Wenjin-GM/ELF_Baobaodui/vision/inventory/auto_verify_annotated.jpg

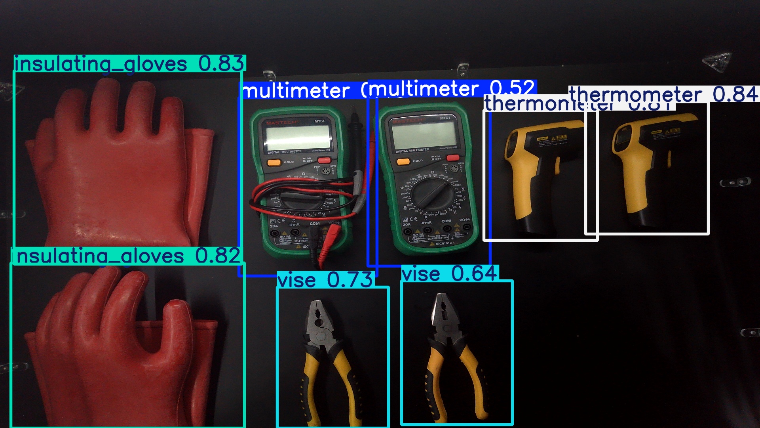
vision/inventory/auto_verify_annotated.jpg
