Wenjin-GM/ELF_Baobaodui/vision/inventory/verify_annotated.jpg

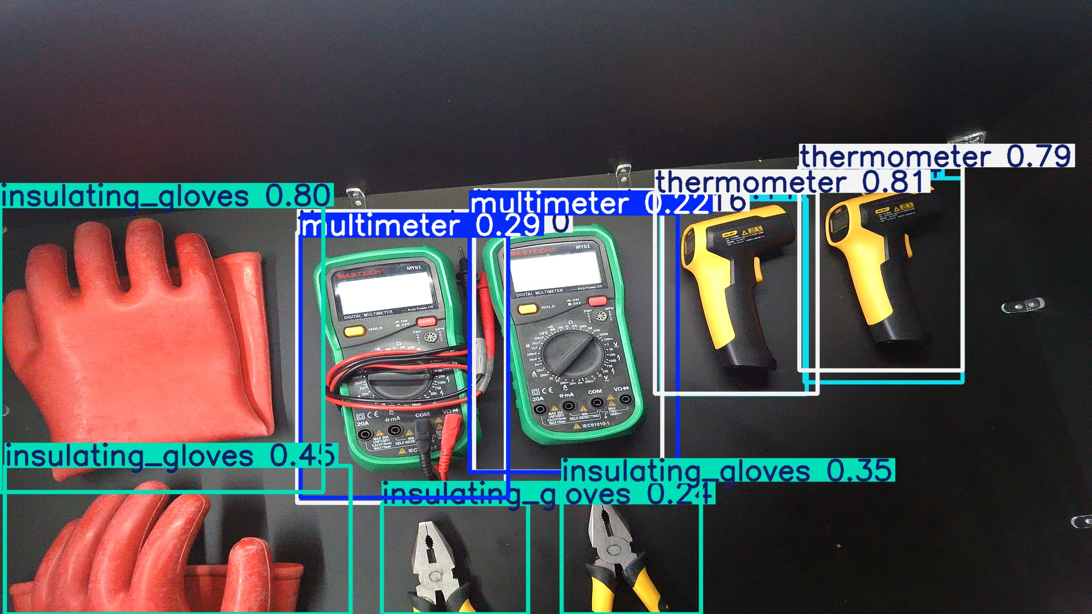
vision/inventory/verify_annotated.jpg
