Wenjin-GM/ELF_Baobaodui/show/New-7.3/Script/SUMMARY.md

# 智能安全工具柜触摸屏界面开发总结

## 项目概述

基于 **智能工具柜触摸屏界面框架大纲.md** 的要求，完成了 PyQt5 触摸屏界面的第一版实现。

**开发日期**: 2026-06-21  
**项目**: 宝宝队 ELF 2 / RK3588 智能安全工具柜  
**目标平台**: ELF2-Desktop 22.04 / RK3588

---

## 已实现的功能

### 1. 核心架构 ✅

- [x] **状态机驱动** (`state_machine.py`)
  - 9 种系统状态：STANDBY, AUTH_PENDING, USER_AUTHED, ADMIN_AUTHED, CABINET_OPEN, CHECKING_AFTER_CLOSE, ALARM_ACTIVE, MAINTENANCE, OFFLINE
  - 每个状态定义默认页面和允许访问的页面列表
  - 状态转换自动触发页面跳转
  - 支持用户权限管理（普通用户/管理员）

- [x] **主窗口框架** (`main_window.py`)
  - QStackedWidget 多页面管理
  - 顶部状态栏：系统名称、当前状态、登录用户、时间
  - 底部导航栏：根据状态动态生成，高亮当前页面
  - 支持点击导航和左右滑动切换页面
  - 滑动范围自动限制在当前状态允许的页面内

- [x] **模拟后端** (`mock_backend.py`)
  - 环境数据模拟（温湿度、风扇状态）
  - 工具状态模拟（五区检测结果）
  - 充电状态模拟（电池盒、4个电池位）
  - 认证事件模拟
  - 报警事件模拟
  - 定时更新机制

### 2. 完整的页面实现 ✅

#### 总览页 (`dashboard_page.py`)
- [x] 五区工具状态网格显示
- [x] 环境状态卡片（温湿度、风扇）
- [x] 充电状态卡片（电池盒、电池位）
- [x] 最近事件流（滚动显示）
- [x] 实时数据更新
- [x] 状态颜色标识

#### 认证页 (`auth_page.py`)
- [x] 摄像头预览区占位
- [x] NFC 刷卡状态显示
- [x] 人脸识别结果显示
- [x] 用户权限显示
- [x] 模拟认证按钮（普通用户/管理员）
- [x] 申请开柜功能
- [x] 退出登录功能

#### 工具盘点页 (`tools_page.py`)
- [x] 五区工具表格
- [x] 登记数量、当前数量、再借数量
- [x] 缺失/错放/正常状态标识
- [x] 状态颜色区分
- [x] 立即盘点按钮
- [x] 最近盘点时间显示

#### 充电管理页 (`charging_page.py`)
- [x] 电池盒在位状态
- [x] 4 个电池位网格显示
- [x] 充电电源开关状态
- [x] 充电检测模块在线状态
- [x] 充电策略显示（自动/手动）
- [x] 手动充电控制按钮

#### 环境监控页 (`environment_page.py`)
- [x] 大字号温湿度显示
- [x] 图标增强可读性
- [x] 风扇/报警器状态
- [x] 合规阈值显示
- [x] 风扇启动/关闭条件
- [x] 最近趋势提示
- [x] 手动风扇控制

#### 记录查询页 (`records_page.py`)
- [x] 操作记录表格
- [x] 按类型筛选（全部/认证/开柜/盘点/充电/环境/报警）
- [x] 时间倒序显示
- [x] 级别颜色标识
- [x] 统计信息
- [x] 导出按钮预留

#### 设置页 (`settings_page.py`)
- [x] 环境阈值设置（温度上下限、湿度上限）
- [x] 风扇控制阈值设置
- [x] 自动控制开关（风扇/充电）
- [x] 进入维护模式
- [x] 导出数据按钮
- [x] 危险操作区（临时开锁、清空记录、重置系统）
- [x] 二次确认对话框

#### 调试维护页 (`debug_page.py`)
- [x] 硬件在线状态列表（I2C、GPIO、摄像头、STM32）
- [x] 系统信息显示
- [x] 单模块测试按钮（8个测试项）
- [x] 运行日志实时显示
- [x] 清空日志按钮
- [x] 退出维护模式

### 3. UI/UX 设计 ✅

- [x] 遵循 design_sense 色彩规范
  - 温暖奶油色背景 `#F7F4EF`
  - 白色卡片 `#FFFFFF`
  - 陶土色强调 `#C4612F`
  - 深色顶栏 `#1F2421`

- [x] 触摸优化
  - 所有主要按钮高度 ≥ 56px
  - 大字号显示关键数据
  - 状态颜色区分
  - 图标增强可读性

- [x] 响应式布局
  - 默认 1024x600 分辨率
  - 支持全屏模式
  - 网格布局自适应

### 4. 辅助文件 ✅

- [x] `config.py` - 系统配置文件
- [x] `README.md` - 项目文档
- [x] `run.sh` - Linux 启动脚本
- [x] `run.bat` - Windows 启动脚本

---

## 核心特性

### 状态机驱动的页面控制

```
STANDBY (待机)
  ↓ 认证成功
USER_AUTHED / ADMIN_AUTHED (已认证)
  ↓ 申请开柜
CABINET_OPEN (柜门打开)
  ↓ 关门
CHECKING_AFTER_CLOSE (盘点中)
  ↓ 盘点完成
STANDBY (返回待机) 或 ALARM_ACTIVE (报警)
```

每个状态自动控制：
1. 默认显示的页面
2. 底部导航栏显示的页面列表
3. 左右滑动允许访问的页面范围

### 双向交互支持

1. **点击导航** - 精确跳转
2. **滑动切换** - 快速浏览
3. **状态自动跳转** - 智能引导

### 模块化设计

```
main.py                    # 入口
  └─ MainWindow            # 主窗口
      ├─ StateMachine      # 状态机
      ├─ MockBackend       # 数据后端
      └─ Pages             # 8个页面
          ├─ DashboardPage
          ├─ AuthPage
          ├─ ToolsPage
          ├─ ChargingPage
          ├─ EnvironmentPage
          ├─ RecordsPage
          ├─ SettingsPage
          └─ DebugPage
```

---

## 运行测试

### 在 Windows 上测试

```bash
cd Show/Script
python main.py
```

### 在 Linux/ELF2 上测试

```bash
cd Show/Script
chmod +x run.sh
./run.sh
```

### 演示流程

1. 启动程序 → 总览页（未认证待机）
2. 点击"认证"导航 → 认证页
3. 点击"模拟管理员认证" → 自动返回总览页（管理员已认证）
4. 底部导航栏自动更新，显示所有可用页面
5. 观察环境数据每秒更新、工具状态每2秒更新、充电状态每3秒更新
6. 点击"申请开柜" → 自动跳转工具页（柜门打开状态）
7. 切换到设置页 → 调整阈值、进入维护模式
8. 在调试页 → 测试各模块、查看日志
9. 左右滑动测试页面切换

---

## 下一步开发计划

### 阶段 1：硬件对接 🚧

- [ ] 创建 `hardware_backend.py`
- [ ] 连接 SHT30 温湿度传感器（I2C4）
- [ ] 连接 PN532 NFC 读卡器（I2C7）
- [ ] 连接 GPIO 继电器（锁、风扇、充电）
- [ ] 连接摄像头，实现实时预览
- [ ] 接入 YOLO26 RKNN 模型推理
- [ ] 连接 STM32 充电检测模块（串口）

### 阶段 2：数据持久化 🚧

- [ ] 创建 SQLite 数据库
- [ ] 实现认证记录表
- [ ] 实现开柜记录表
- [ ] 实现工具盘点记录表
- [ ] 实现充电记录表
- [ ] 实现环境记录表
- [ ] 实现报警记录表
- [ ] 记录导出 CSV 功能

### 阶段 3：功能完善 🚧

- [ ] 摄像头实时预览
- [ ] 人脸识别算法集成
- [ ] NFC 卡管理界面
- [ ] 工具登记/注销功能
- [ ] 环境历史曲线图（matplotlib）
- [ ] 页面切换动画效果
- [ ] 声音提示反馈
- [ ] 网络状态监控

### 阶段 4：优化与测试 🚧

- [ ] 性能优化（减少 CPU/内存占用）
- [ ] YOLO 推理性能测试
- [ ] 触摸响应优化
- [ ] 长时间运行稳定性测试
- [ ] 异常情况处理测试
- [ ] 用户体验优化

---

## 技术亮点

1. **状态机架构** - 清晰的状态定义和转换逻辑，便于维护和扩展
2. **模块化设计** - 页面独立，后端可替换，易于测试
3. **Mock 数据支持** - 无需硬件即可开发演示
4. **信号槽机制** - PyQt5 信号槽实现解耦
5. **设计规范遵循** - 完全符合 design_sense 色彩和触摸规范

---

## 文件清单

```
Show/Script/
├── main.py                     # 主程序入口
├── main_window.py              # 主窗口（668 行）
├── state_machine.py            # 状态机（238 行）
├── mock_backend.py             # 模拟后端（236 行）
├── config.py                   # 配置文件（151 行）
├── README.md                   # 项目文档
├── run.sh                      # Linux 启动脚本
├── run.bat                     # Windows 启动脚本
└── pages/
    ├── __init__.py             # 包初始化
    ├── dashboard_page.py       # 总览页（234 行）
    ├── auth_page.py            # 认证页（192 行）
    ├── tools_page.py           # 工具页（151 行）
    ├── charging_page.py        # 充电页（244 行）
    ├── environment_page.py     # 环境页（272 行）
    ├── records_page.py         # 记录页（144 行）
    ├── settings_page.py        # 设置页（303 行）
    └── debug_page.py           # 调试页（286 行）

总计：约 3200+ 行代码
```

---

## 项目记忆对齐

✅ 完全符合 `agent.md` 和项目记忆要求：
- 工作名：基于 RK3588 的电网运维智能安全工具柜系统
- 平台：ELF 2 / RK3588
- 视觉模型：YOLO26
- 目标类别：wrench, coil, insulating_glove, temperature_gun
- 充电协议：STM32 解码，PB0/PB1/PB10 与 ELF 通信
- 五区规划：1区充电、2区钳子、3区测温枪、4区万用表、5区绝缘手套

---

## 总结

第一版界面框架已完整实现，包含：
- ✅ 完整的 8 个页面
- ✅ 状态机驱动的页面控制
- ✅ 模拟数据实时更新
- ✅ 触摸优化的 UI 设计
- ✅ 可在 PC 和板端运行

**当前状态**: 可演示、可滑动、可点击、可模拟认证和开柜流程  
**下一步**: 接入实际硬件，替换 MockBackend 为 HardwareBackend

---

**开发者**: Claude (Kiro)  
**审核者**: 宝宝队  
**日期**: 2026-06-21
