Wenjin-GM/ELF_Baobaodui/show/New-7.3/Script/resources/ui_images/charging_box.png

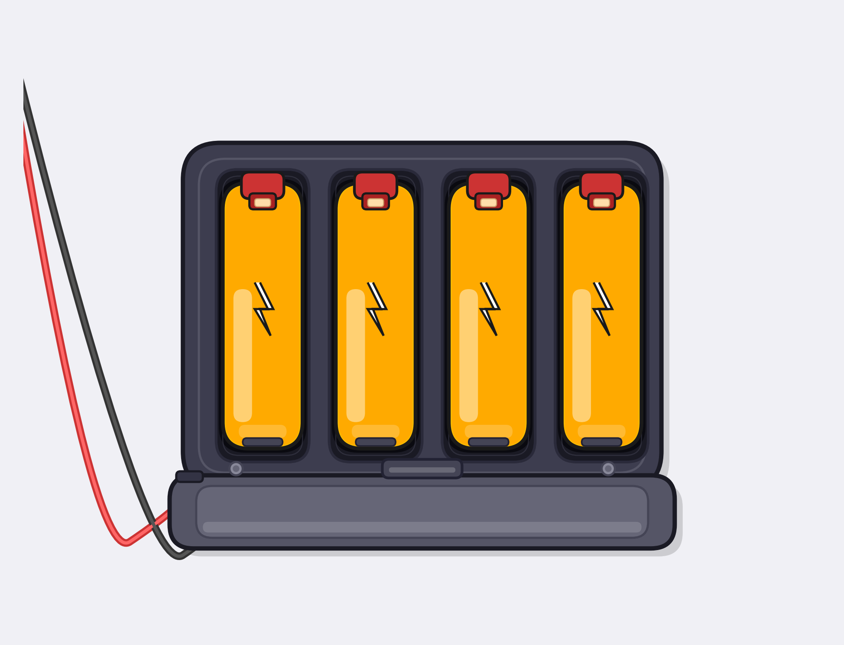
show/New-7.3/Script/resources/ui_images/charging_box.png
