Wenjin-GM/ELF_Baobaodui/show/New-7.3/Script/resources/ui_images/environment_status.png

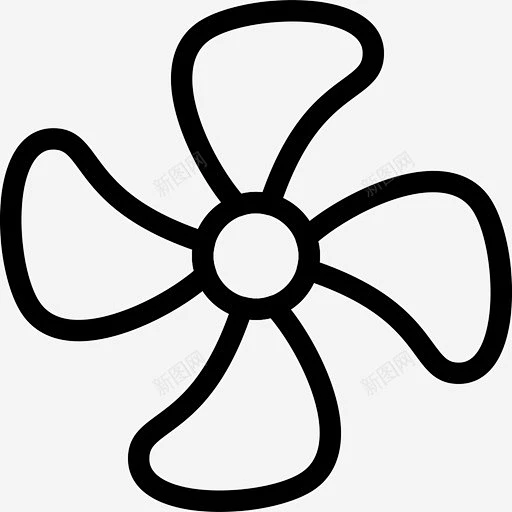
show/New-7.3/Script/resources/ui_images/environment_status.png
