Wenjin-GM/ELF_Baobaodui/show/New-7.3/Script/resources/ui_images/login_success.jpg

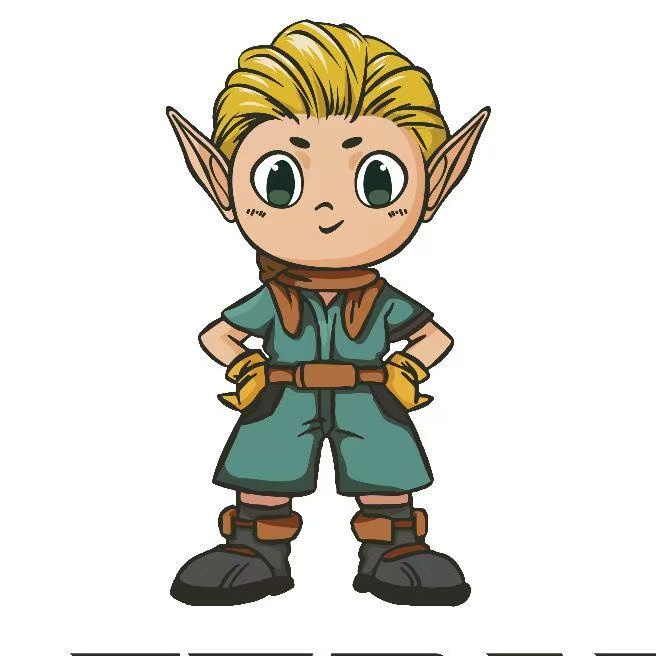
show/New-7.3/Script/resources/ui_images/login_success.jpg
