Wenjin-GM/ELF_Baobaodui/show/New-7.3/Script/resources/ui_images/tool_battery_box.png

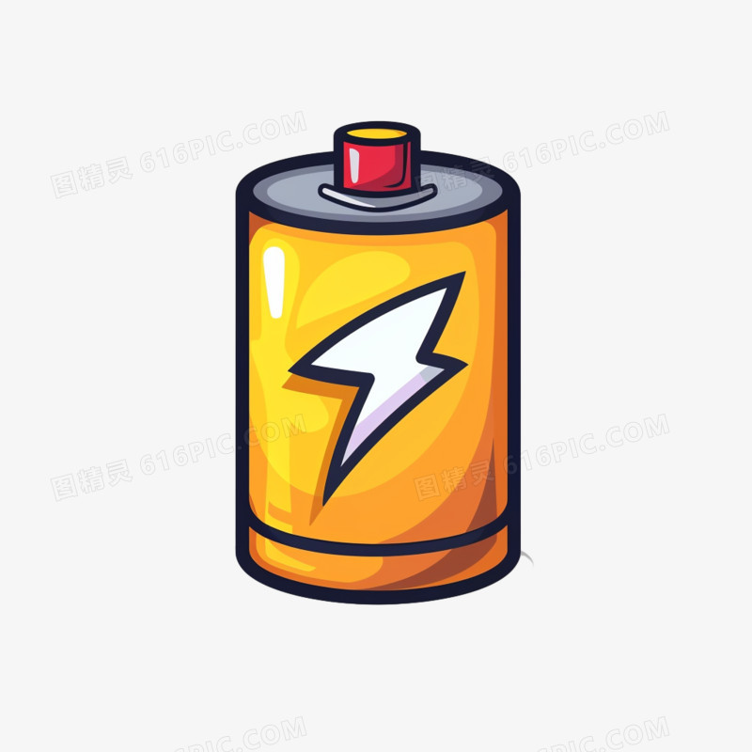
show/New-7.3/Script/resources/ui_images/tool_battery_box.png
