Wenjin-GM/ELF_Baobaodui/show/New-7.3/Script/resources/ui_images/tool_pliers.png

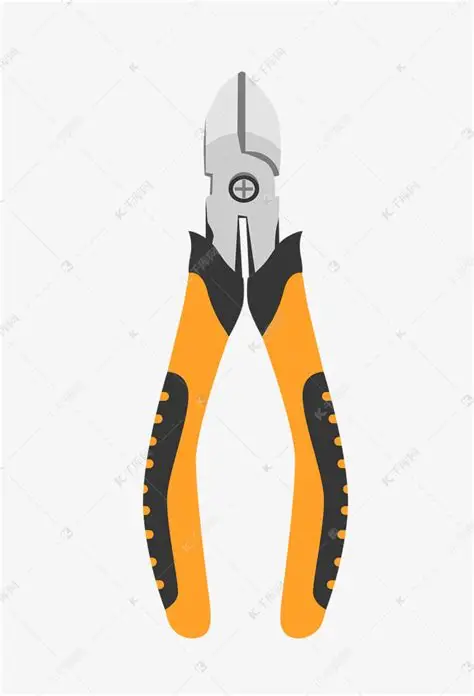
show/New-7.3/Script/resources/ui_images/tool_pliers.png
