Wenjin-GM/ELF_Baobaodui/show/New-7.3/Script/resources/ui_images/tool_thermometer.png

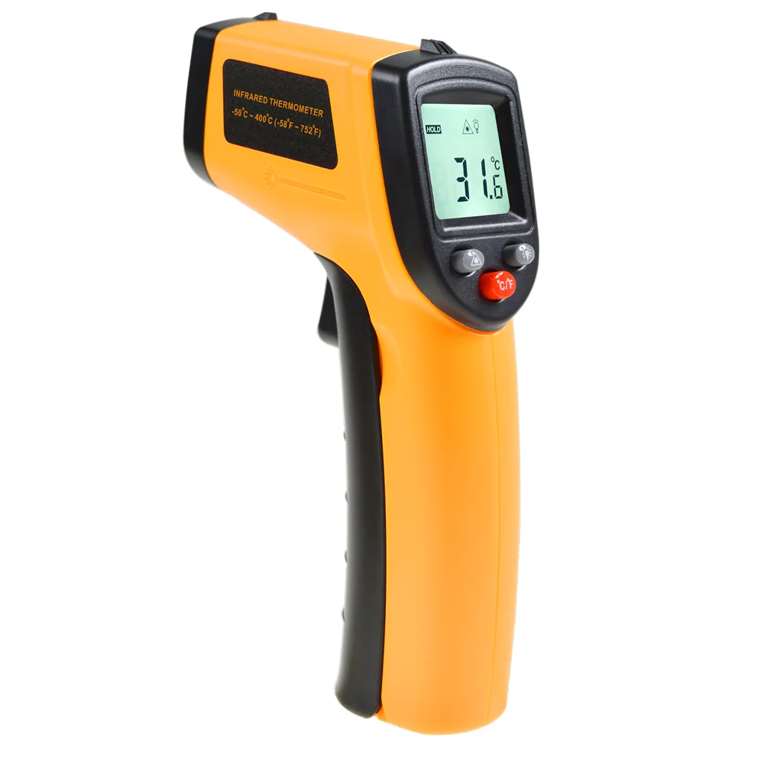
show/New-7.3/Script/resources/ui_images/tool_thermometer.png
