Wenjin-GM/ELF_Baobaodui/data/inventory_dataset/raw/新建文件夹/cabinet_20260703_200147_01.jpg

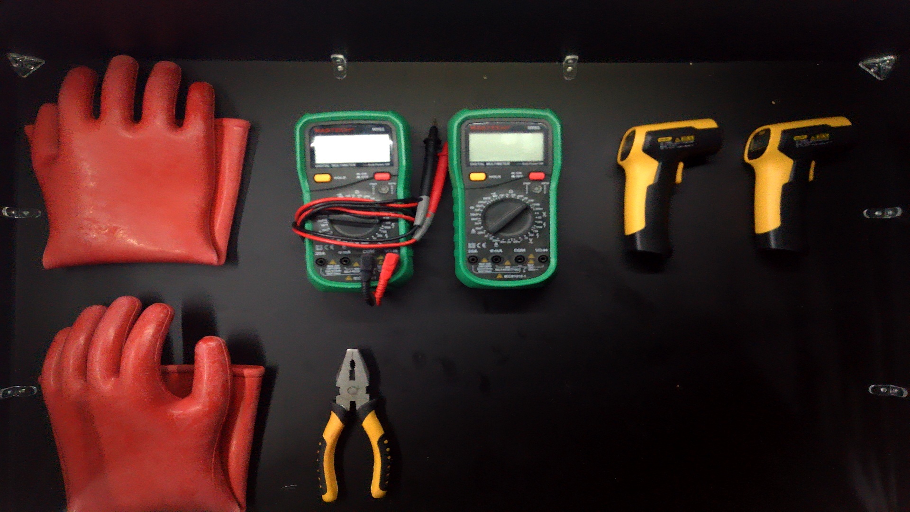
data/inventory_dataset/raw/新建文件夹/cabinet_20260703_200147_01.jpg
