Wenjin-GM/ELF_Baobaodui/vision/inventory/current_cabinet_photo.jpg

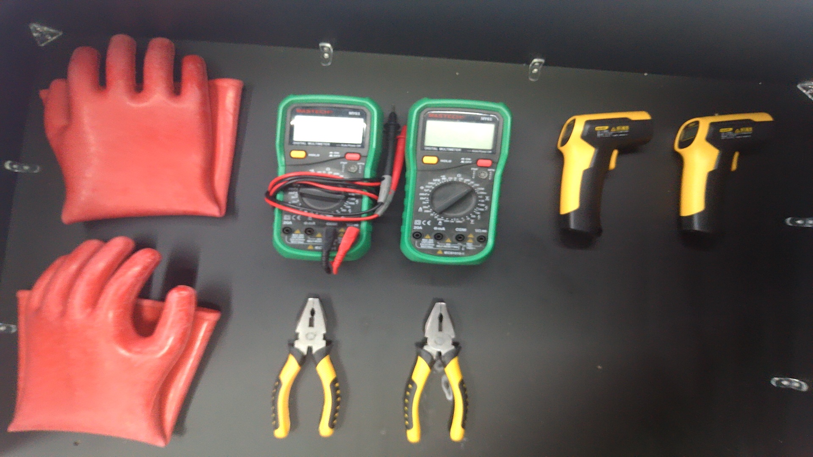
vision/inventory/current_cabinet_photo.jpg
