Wenjin-GM/ELF_Baobaodui/vision/inventory/verify_original.jpg

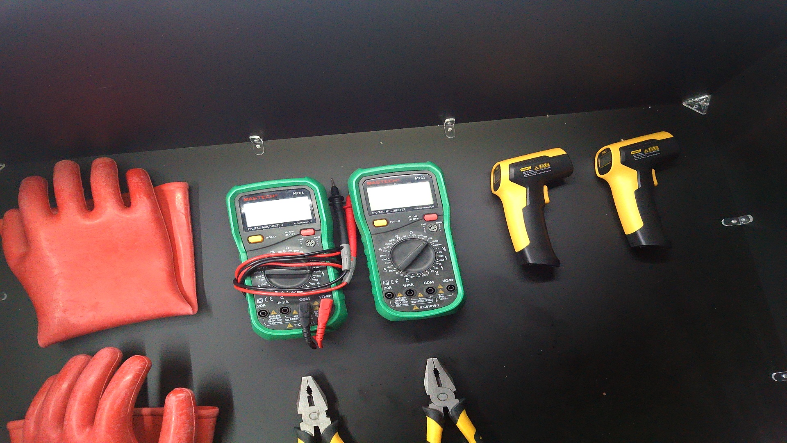
vision/inventory/verify_original.jpg
