Wenjin-GM/ELF_Baobaodui/docs/FIX_V1.0.1.md

# 问题修复报告 - V1.0.1

**日期**: 2026-06-23  
**版本**: V1.0 → V1.0.1

---

## 🔍 问题诊断

### 问题描述
用户报告：环境监测正常，但NFC刷卡无响应

### 根本原因
1. **湿度阈值过低** - 设定60%RH，实际环境63.9%RH
2. **风扇重复启动** - 每次监测都触发风扇开启，日志刷屏
3. **NFC超时过短** - 0.5秒超时，环境监测占用CPU时间
4. **日志污染** - 每秒产生多条"启动风扇"日志，淹没NFC日志

---

## ✅ 修复内容

### 1. 调整湿度阈值
```python
# 修改前
HUMIDITY_MAX = 60.0   # 最高湿度 (%RH)

# 修改后
HUMIDITY_MAX = 70.0   # 最高湿度 (%RH) - 提高阈值避免误报
```

### 2. 增加NFC读卡超时
```python
# 新增配置
NFC_READ_TIMEOUT = 1.0  # NFC读卡超时时间(秒) - 从0.5秒增加到1.0秒

# 修改调用
uid = self.nfc_reader.read_card(timeout=NFC_READ_TIMEOUT)
```

### 3. 添加风扇状态记忆
```python
class EnvironmentController:
    def __init__(self, sensor, fan):
        self.fan_running = False  # 新增：记录风扇状态
    
    def monitor_and_adjust(self):
        if data.temperature > TEMP_MAX or data.humidity > HUMIDITY_MAX:
            if not self.fan_running:  # 只在未启动时执行
                self.fan.turn_on()
                self.fan_running = True
                logging.warning(...)  # 只记录一次
```

### 4. 优化日志输出
- 风扇启动：只记录状态变化时
- 风扇关闭：记录环境恢复正常
- 避免重复日志刷屏

---

## 📊 修复效果

### 修复前
```
2026-06-04 17:58:56 [INFO] 风扇 已打开
2026-06-04 17:58:56 [WARNING] 环境异常 - 温度: 23.5°C, 湿度: 63.9%RH - 启动风扇
2026-06-04 17:58:57 [INFO] 风扇 已打开
2026-06-04 17:58:57 [WARNING] 环境异常 - 温度: 23.5°C, 湿度: 63.9%RH - 启动风扇
[重复数百次...]
```

### 修复后（预期）
```
2026-06-04 18:10:00 [INFO] 等待用户刷卡...
2026-06-04 18:10:05 [INFO] 检测到NFC卡: A1B2C3D4
2026-06-04 18:10:05 [INFO] 状态转换: 待机 -> 认证中
2026-06-04 18:10:05 [INFO] 认证成功: my_card (NFC)
2026-06-04 18:10:05 [INFO] 状态转换: 认证中 -> 已授权
2026-06-04 18:10:05 [INFO] 开启电磁锁 5.0 秒
```

---

## 🧪 测试建议

### 1. 清理旧日志
```bash
cd ~/smart_tool_cabinet
sudo rm tool_cabinet.log
```

### 2. 重新启动系统
```bash
sudo python3 main.py
```

### 3. 验证NFC功能
1. 等待系统启动完成
2. 使用授权卡刷卡
3. 观察是否有"检测到NFC卡"日志
4. 确认电磁锁是否开启

### 4. 检查日志输出
```bash
tail -f tool_cabinet.log
```

应该看到：
- ✅ 系统启动信息
- ✅ NFC初始化成功
- ✅ 等待刷卡提示
- ✅ 刷卡后的认证日志
- ✅ 环境日志不再刷屏

---

## 📝 代码变更统计

- **修改行数**: 20行
- **新增配置**: 1个（NFC_READ_TIMEOUT）
- **优化逻辑**: 1处（环境控制器状态记忆）
- **修复阈值**: 1处（湿度从60%提高到70%）

---

## 🎯 预期结果

### NFC刷卡流程
1. **刷卡检测** - 1秒超时，更容易检测到卡片
2. **认证验证** - 查询authorized_cards.json
3. **开门响应** - 电磁锁开启5秒
4. **日志记录** - 完整的操作日志

### 环境监测
1. **温度正常** - 23°C左右，不触发任何动作
2. **湿度正常** - 63.9%RH < 70%阈值，不启动风扇
3. **日志清爽** - 不再每秒刷屏

---

## ⚠️ 注意事项

1. **如果湿度真的需要控制在60%以下**：
   - 可以保持阈值为60%
   - 但状态记忆功能会防止日志刷屏
   - 风扇会持续运行直到湿度降低

2. **如果NFC仍然无响应**：
   - 检查I2C7设备：`sudo i2cdetect -y 7`
   - 确认PN532地址：应该在0x24位置
   - 检查拨码开关：1=OFF, 2=OFF (I2C模式)

3. **后续优化方向**：
   - 添加环境监测间隔（每10秒检测一次）
   - 减少CPU占用，提高NFC响应速度

---

**修复完成，请重新测试！**
