Wenjin-GM/ELF_Baobaodui/(commit log)

2026-06-27 update pn532 i2c diagnostics
2026-06-29 fix face preview threading path
    [auth_page.py, face_node.py, ros_backend.py]
2026-07-15 Update UI controls and inventory calibration
2026-07-16 Publish battery updates immediately
